Teknoid303/BBTRaceGateProject/media/BillYoureAwesome.jpg

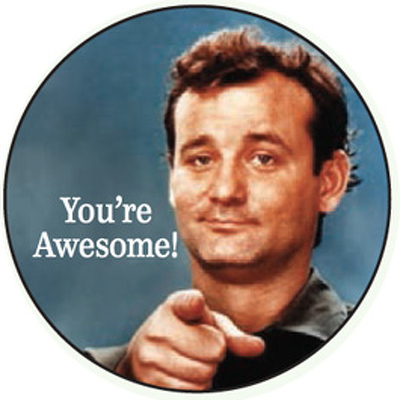
media/BillYoureAwesome.jpg
