Teknoid303/BBTRaceGateProject/docs/partslist.md

# BBT Race Gate Parts List

Here is a list of the parts you will need to build a race gate. There are links here to amazon.com and aliexpress, but these are only there to show an example of the needed part. You can purchase the parts from anywhere you'd like.

- 1 - 3D Printed Base and Lid - Download from Thingiverse or the ./stl directory. (link will be up soon)
- 1 - Arduino NANO v3.0 or Clone (ATMEGA328p 5v) https://www.amazon.com/gp/product/B015MGHH6Q
- 1 - Rotary Encoder w/ Switch - https://www.amazon.com/DIYhz-Rotary-Encoder-Digital-Potentiometer/dp/B07D3D64X7 
- 1 - Rotary Encoder Knob - https://www.amazon.com/uxcell-Potentiometer-Control-Electric-Acrylic/dp/B07T4YWZFR
- 1 - 5.5mm x 2.1mm Barrel Jack - https://www.amazon.com/ThreeBulls-Pieces-5-5mmx2-1mm-Female-Connector/dp/B01N8VV78D
- 1 - LED Strip - DC 5V WS2812B strip 60leds/m IP30 5m/roll white - https://www.aliexpress.com/item/32242633143.html
- 1 - 5 ft 1/2" White PEX Piping -  https://www.lowes.com/pd/SharkBite-1-2-in-x-100-ft-PEX-Pipe/1000168483
- 1 - 470 ohm resistor - https://www.amazon.com/EDGELEC-Resistor-Tolerance-Multiple-Resistance/dp/B07QG1V4BH
- Various Wire
