Teknoid303/BBTRaceGateProject/stl/BBTRaceGateLid.stl

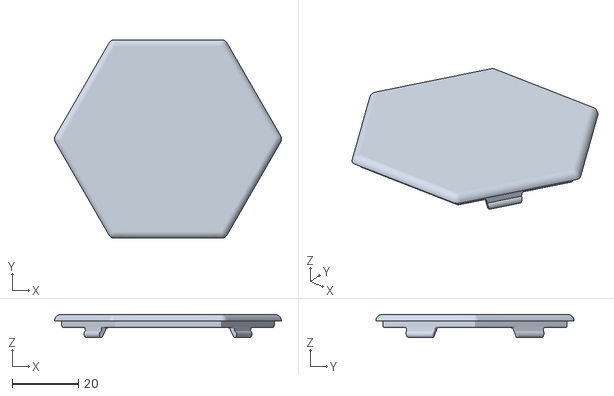
[picture p6: CAD file, 2020-01-14]
stl/BBTRaceGateLid.stl
68.7 x 60.0 x 7.00
