Teknoid303/BBTRaceGateProject/stl/BBTRaceGateBase.stl

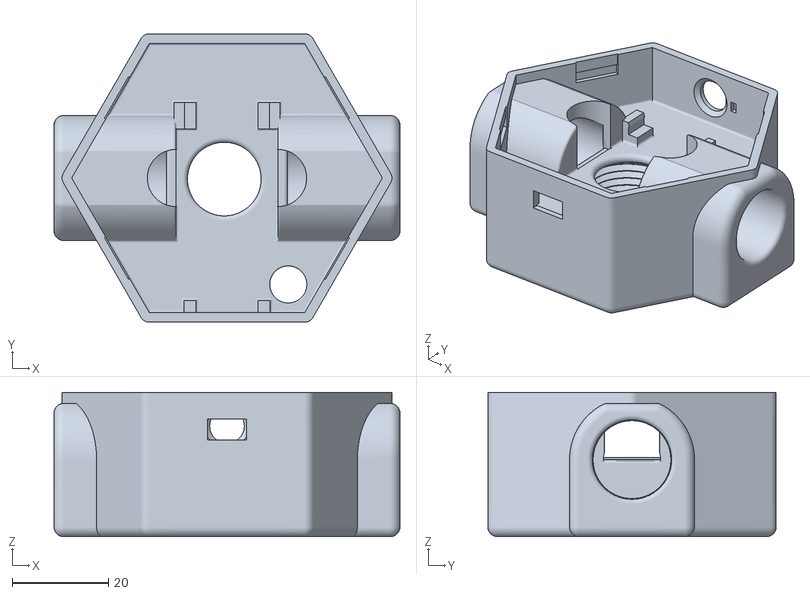
[picture p7: CAD file, 2020-01-14]
stl/BBTRaceGateBase.stl
72.0 x 60.0 x 30.0
