Teknoid303/BBTRaceGateProject/(commit log)

2020-01-08 Update README.md
    Completed the Logo, TOC, Releases (needs work), Features, and Overview sections today. Finishing up the schematic.
2020-01-08 Add hardware schematic
    Adding first version of the schematic
2020-01-08 Adding schematic
    Adding a schematic drawing for the project
2020-01-14 placeholder for directory creation
    [BBTRaceGateBase.stl]
2020-01-14 3D STL Files for Base and Lid
    [BBTRaceGateBase.stl, BBTRaceGateLid.stl]
2020-01-24 Add files via upload
    Adding funny video about first board attempt.
2020-01-24 Correction on the number of LEDs in the loop.
